Monash-BoSL/BoSLcam/README.md

Hardware repository for the BoSLcam, IoT camera.
