Monash-BoSL/BoSLcam/EDA/BoSLcam_bom_rev1.2.0.xlsx

Part Number | Package Size / Type | Schematic Designator | Component | Notes | Value | QTY per board | Unit Price | Total Price | Mouser | Digikey
2337019-1 |  | AT1, AT2 | U.FL Antenna Connector |  |  | 2 | $0.30 | $0.60 | https://au.mouser.com/ProductDetail/TE-Connectivity/2337019-1 | https://www.digikey.com.au/en/products/detail/te-connectivity-amp-connectors/2337019-1/9974052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
PCG1A101MCL1GS |  | C1 | SMD Capacitor |  | 150 uF | 1 | $2.64 | $2.64 | https://au.mouser.com/ProductDetail/United-Chemi-Con/EMZR100ARA151ME61G?qs=y6ZabgHbY%252Bx2AFa1qTrwQQ%3D%3D | https://www.digikey.com.au/en/products/detail/nichicon/PCG1A101MCL1GS/2786815
Any Applicable | 0402 | C10 | SMD Capacitor |  | 220 pF | 1 | $0.02 | $0.02 |  | https://www.digikey.com.au/en/products/detail/walsin-technology-corporation/0402N221J500CT/9354783
Any Applicable | 0402 | C12 | SMD Capacitor |  | 1 nF | 1 | $0.01 | $0.01 |  | https://www.digikey.com.au/en/products/detail/kemet/C0402C102K5RAC7867/411034
Any Applicable | 0402 | C2,C3,C5,C8,C11,C18,C19 | SMD Capacitor |  | 100 nF | 7 | $0.03 | $0.18 |  | https://www.digikey.com.au/en/products/detail/kemet/C0402C104K8PAC7867/447631
Any Applicable | 0805 | C4, C17 | SMD Capacitor |  | 10 uF | 2 | $0.06 | $0.13 |  | https://www.digikey.com.au/en/products/detail/samsung-electro-mechanics/CL21A106KOQNNNE/3886754
Any Applicable | 0402 | C6,C9 | SMD Capacitor |  | 15 pF | 2 | $0.02 | $0.04 |  | https://www.digikey.com.au/en/products/detail/samsung-electro-mechanics/CL05C150JB5NNNC/3886837
Any Applicable | 0402 | C7 | SMD Capacitor |  | 1 uF | 1 | $0.05 | $0.05 |  | https://www.digikey.com.au/en/products/detail/kyocera-avx/04026D105KAT2A/717511
 | 0603 | D1 | SMD LED |  |  | 1 | $0.16 | $0.16 |  | https://www.digikey.com.au/en/products/detail/harvatek-corporation/B1911USD-20D000114U1930/15519991
XQAAWT-02-0000-00000B4E3 | CREE-XQ | D2-D4 | SMD LED |  | White | 3 | $1.16 | $3.48 | https://au.mouser.com/ProductDetail/Cree-LED/XQAAWT-02-0000-00000B4E3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
S2B-PH-SM4-TB(LF)(SN) |  | J2 | JST PH |  |  | 1 |  | $0.00 |  | https://www.digikey.com.au/en/products/detail/molex/1040310811/2370379?s=N4IgTCBcDaIAQEYAMAWJBmBBaJAOBCIAugL5A
104031-0811 Molex |  | J3 | microSD connector |  |  | 1 | $3.59 | $3.59 | https://au.mouser.com/ProductDetail/Molex/104031-0811?qs=sGAEpiMZZMuJakaoiLiBpj1mGp1aVlb8QxJnovvyiw8%3D | https://www.digikey.com.au/en/products/detail/hirose-electric-co-ltd/FH26W-25S-0-3SHW-60/5132498
FH26W-25S-0.3SHW(60) |  | J6 | Camera Connector |  |  | 1 | $2.51 | $2.51 | https://au.mouser.com/ProductDetail/Hirose-Connector/FH26W-25S-0.3SHW60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 | https://www.digikey.com.au/en/products/detail/molex/1042240820/7785572?s=N4IgTCBcDaIAQEYAMAWMYUFokA4xJAF0BfIA
SIM Card Holder | Nano SIM | J9 | SIM Card Holder |  |  | 1 | $2.34 | $2.34 | https://au.mouser.com/ProductDetail/Molex/104224-0820 | https://www.digikey.com.au/en/products/detail/epcos-tdk-electronics/B82496C3100J000/697499
LQW18AN9N1D00D | 0603 | L1 | Inductor |  | 9.1 nH | 1 | $0.22 | $0.22 | https://au.mouser.com/ProductDetail/Murata-Electronics/LQW18AN9N1D00D?qs=EPZCdHdMnYJMYfHLXCR5Dg%3D%3D
DMN2310U | SOT-23 | Q1 | N channel MOSFET |  |  | 1 | $0.36 | $0.36 | https://au.mouser.com/ProductDetail/Diodes-Incorporated/DMN2310U-7?qs=xZ%2FP%252Ba9zWqY%252BAdKLxIytvQ%3D%3D
Any Applicable | 0603 | R1,R3,R9 | SMD resistor |  | 47 Ω | 3 | 0.1 | $0.30
Any Applicable | 0402 | R2, R4-R6, R8 | SMD Resistor |  | 10 kΩ | 5 | $0.02 | $0.09 |  | https://www.digikey.com.au/en/products/detail/yageo/RC0402JR-0739RL/726472
Any Applicable | 0402 | R7 | SMD Resistor |  | 39 Ω | 1 | $0.01 | $0.01
SKTHAHE010 |  | SW1, SW2 | Tactile Switch |  |  | 2 | $0.28 | $0.56 | https://au.mouser.com/ProductDetail/Alps-Alpine/SKTHAHE010/?qs=T3oQrply3y8NYoSxPHM%252Buw== | https://www.digikey.com.au/en/products/detail/microchip-technology/23LCV1024-I-SN/3543093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
23LCV1024-I/SN | SOIC-8 | U1 | SRAM |  | 1024kbit | 0 | $4.88 | $0.00 | https://au.mouser.com/ProductDetail/Microchip-Technology-Atmel/23LCV1024-I-SN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 | https://www.digikey.com.au/en/products/detail/MCP1700T-3302E-TT/MCP1700T3302ETTCT-ND/652677?curr=usd
MCP1700T-3302E/TT | SOT-23 | U2 | Voltage Regulator |  |  | 1 | $0.80 | $0.80 | https://au.mouser.com/ProductDetail/Microchip-Technology/MCP1700T-3302E-TT/?qs=fM4xO01eazPmCNDrdHEdaw== | https://www.digikey.com.au/en/products/detail/nordic-semiconductor-asa/NRF9160-SICA-B1A-R7/13533588
nRF9160-SICA | SiP | U3 | LTE Modem |  |  | 1 | $44.00 | $44.00 | https://au.mouser.com/ProductDetail/Nordic-Semiconductor/nRF9160-SICA-R/?qs=PqoDHHvF648umA0p6bFBjQ== | https://www.digikey.com.au/en/products/detail/infineon-technologies/BGA524N6E6327XTSA1/4759552
BGA524N6E6327XTSA1 | TSNP-6 | U5 | GNSS LNA |  |  | 1 | $1.35 | $1.35 | https://au.mouser.com/ProductDetail/Infineon/BGA-524N6-E6327?qs=y2kkmE52mdNrNs61bDY0pA%3D%3D | https://www.digikey.com.au/en/products/detail/onsemi/MSQA6V1W5T2G/919871
MSQA6V1W5T2G | SOT-353 | U6 | ESD Protection Diodes |  |  | 1 | $0.47 | $0.47 | https://au.mouser.com/ProductDetail/onsemi/MSQA6V1W5T2G?qs=ZpPixqFcBtwjV88RzJj%2FWw%3D%3D
MIC94093YC6 | SC-70-6 | U7 | Power Switch |  |  | 0 | $0.86 | $0.00 | https://au.mouser.com/ProductDetail/Microchip-Technology/MIC94093YC6-TR?qs=Y3Q3JoKAO1Sx33RwJzV5Yg%3D%3D
OV7675 |  |  | Camera |  |  | 1 | $2.99 | $2.99 | https://www.uctronics.com/1/9-ov7675-standalone-vga-coms-camera-module.html
