Monash-BoSL/BoSLcam/EDA/image_light_bom.xlsx

Part Number | Package Size / Type | Schematic Designator | Component | Notes | Value | QTY per board | Unit Price | Total Price | Mouser | Digikey
XQAAWT-02-0000-00000B4E3 | CREE-XQ | D1 - D3 | SMD LED |  | White | 3 | $1.16 | $3.48 | https://au.mouser.com/ProductDetail/Cree-LED/XQAAWT-02-0000-00000B4E3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
DMN2310U | SOT-23 | Q1 | N channel MOSFET |  |  | 1 | $0.36 | $0.36 | https://au.mouser.com/ProductDetail/Diodes-Incorporated/DMN2310U-7?qs=xZ%2FP%252Ba9zWqY%252BAdKLxIytvQ%3D%3D
Any Applicable | `0805 | R1 - R3 | SMD resistor |  | 47 Ω | 3 | 0.1 | $0.30
 |  |  |  |  |  |  | total: | $4.14
