Monash-BoSL/BoSLcam/EDA/BoSLcam_schematic_rev1.2.0.pdf

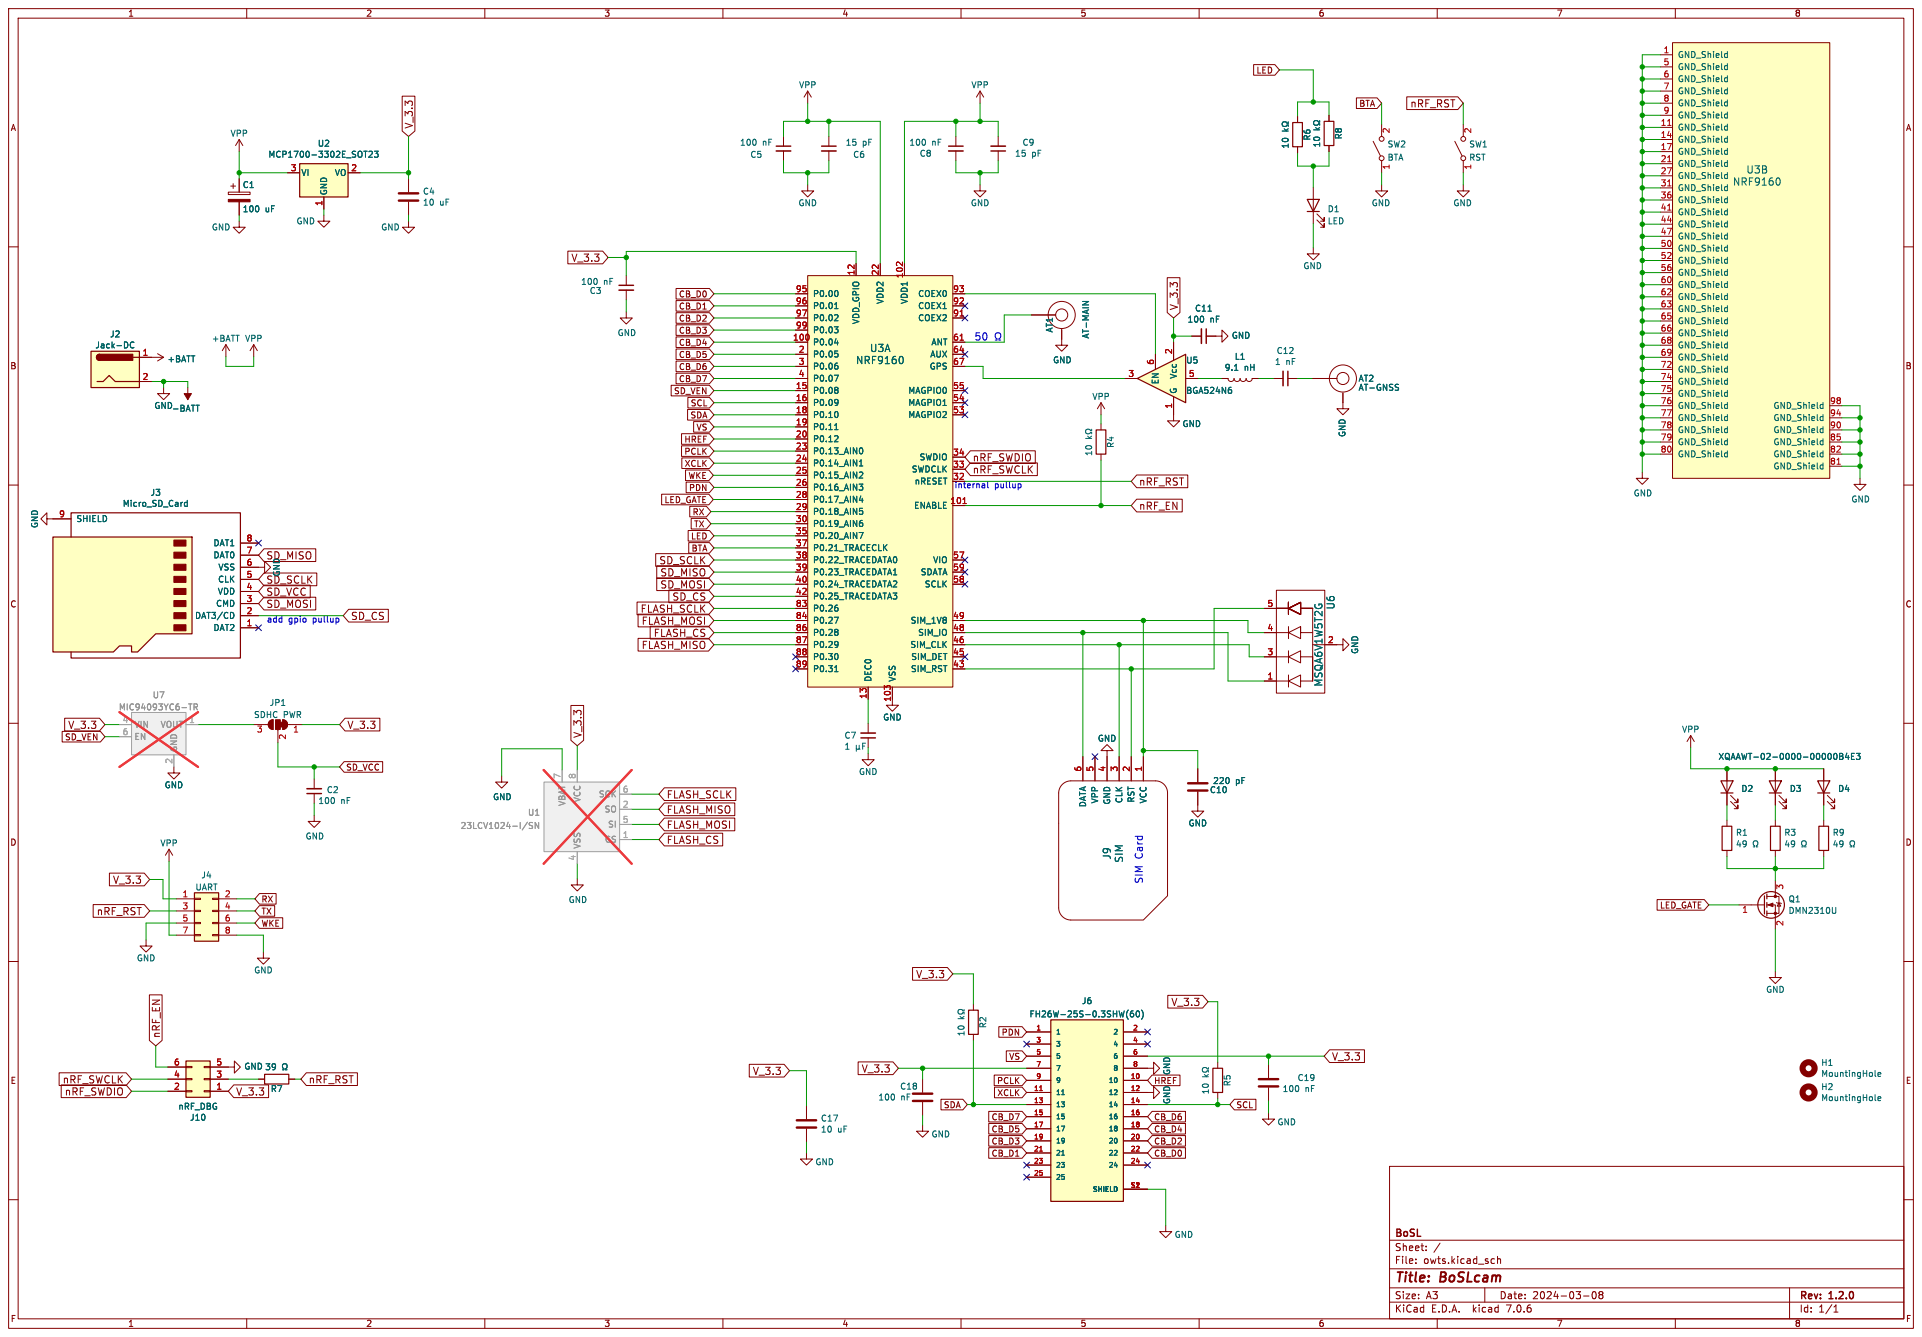
[picture p1: page 1]

GND R2 10 þÿk© GND
LED R5 10 þÿk© GND GND

1 VO 2 VI 3 GND-BATT

File: owts.kicad_sch Sheet: / BoSL
