Monash-BoSL/BoSLcam/(commit log)

2020-07-21 added case design
    [Turbid_Test.kicad_pcb, Turbid_Test.sch]
2020-07-21 added shorter case
    [Turbid_Test.sch]
2022-05-05 working on way to save arducam data to computer file
    [Turbid_Test.kicad_pcb, Turbid_Test.sch]
2022-09-15 added eda and noram atmega image download
    [owts.kicad_pcb, owts.kicad_sch, owts.sch]
2022-10-03 adding camera pcb and schematic to test platform
    [owts.kicad_pcb, owts.kicad_sch]
2022-10-10 began work on nrf9160 based camera platform
    [nRF_dev.kicad_pcb, nRF_dev.kicad_sch, nRF_dev.sch, owts.kicad_pcb, owts.kicad_sch, owts.sch]
2022-10-25 working on nrf camera board
    [nRF_dev.kicad_sch]
2022-10-30 adding layout work for nrf_dev pcb
    [nRF_dev.kicad_pcb, nRF_dev.kicad_sch, owtp_nRF_dev_bom rev0.0.1.xlsx]
2022-10-31 more layout work
    [nRF_dev.kicad_pcb, nRF_dev.kicad_sch]
2022-11-06 finished layout and gerber files for nRF dev camera
    [nRF_dev-B_Cu.gbr, nRF_dev-B_Mask.gbr, nRF_dev-B_Paste.gbr, nRF_dev-B_Silkscreen.gbr, nRF_dev-Edge_Cuts.gbr, nRF_dev-F_Cu.gbr, nRF_dev-F_Mask.gbr, nRF_dev-F_Paste.gbr]
2022-11-23 fixed pcb errors
    [nRF_dev.kicad_pcb, nRF_dev.kicad_sch, nRF_dev.sch]
2022-11-24 fixed typo on silkscreen
    [nRF_dev.kicad_pcb]
2022-12-02 revision 0.0.3 of the nRF dev board
    [nRF_dev-B_Cu.gbr, nRF_dev-B_Mask.gbr, nRF_dev-B_Paste.gbr, nRF_dev-B_Silkscreen.gbr, nRF_dev-Edge_Cuts.gbr, nRF_dev-F_Cu.gbr, nRF_dev-F_Mask.gbr, nRF_dev-F_Paste.gbr]
2022-12-16 updated power saving features
    [nRF_dev.kicad_sch, owts.kicad_pcb, owts.kicad_sch, owts.sch]
2022-12-19 schematic for deployment pcb
2022-12-21 added new routing optimisation
    [nRF_dev-B_Cu.gbr, nRF_dev-B_Mask.gbr, nRF_dev-B_Paste.gbr, nRF_dev-B_Silkscreen.gbr, nRF_dev-Edge_Cuts.gbr, nRF_dev-F_Cu.gbr, nRF_dev-F_Mask.gbr, nRF_dev-F_Paste.gbr]
2022-12-21 added production files
    [nRF_dev-B_Cu.gbr, nRF_dev-B_Mask.gbr, nRF_dev-B_Paste.gbr, nRF_dev-B_Silkscreen.gbr, nRF_dev-Edge_Cuts.gbr, nRF_dev-F_Cu.gbr, nRF_dev-F_Mask.gbr, nRF_dev-F_Paste.gbr]
2022-12-21 added schematic pdf
2023-01-16 fixed pcb footprint error - need to update pcb
    [owts.kicad_pcb, owts.kicad_sch]
2023-04-06 fixed footprint issue on U7 sd card power switch removed battery voltage divider network
    [owtp bom rev1.0.0.xlsx, owts.kicad_sch]
2023-04-12 revsions release rev1.1.0
    [owtp bom rev1.0.0.xlsx, owtp bom rev1.1.0.xlsx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]
2024-02-20 adding new kicad .gitignore
2024-02-20 adding image light pcb and gerber
    [image_light-B_Cu.gbr, image_light-B_Mask.gbr, image_light-B_Paste.gbr, image_light-B_Silkscreen.gbr, image_light-Edge_Cuts.gbr, image_light-F_Cu.gbr, image_light-F_Mask.gbr, image_light-F_Paste.gbr]
2024-02-20 updated image light to include mountpoint and LED dim jumper
    [image_light-B_Cu.gbr, image_light-B_Mask.gbr, image_light-B_Paste.gbr, image_light-B_Silkscreen.gbr, image_light-Edge_Cuts.gbr, image_light-F_Cu.gbr, image_light-F_Mask.gbr, image_light-F_Paste.gbr]
2024-03-08 wip: layout
    [owtp bom rev1.1.0.xlsx, owts.kicad_pcb, owts.kicad_sch]
2024-03-11 releasing rev1.2.0
    [BoSLcam_bom_rev1.2.0.xlsx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]
2024-04-19 fixed issue with L1 on BoM
    [BoSLcam_bom_rev1.2.0.xlsx]
